fduignan/nrf52833/README.md

# nrf52833
Various projects involving the NRF52833 from Nordic Semiconductor.
The DublinMaker2022 project contains firmware for the Dublin Maker 2022 badge.  
It includes a number of games and badge to badge communications.  More details
over at https://ioprog.com
