fduignan/nrf52833/DublinMaker2022/KiCAD_PCB/dmb2022/dmb2022.kicad_pcb

## KiCad design DublinMaker2022/KiCAD_PCB/dmb2022/dmb2022.kicad_pcb (2022-07-27)

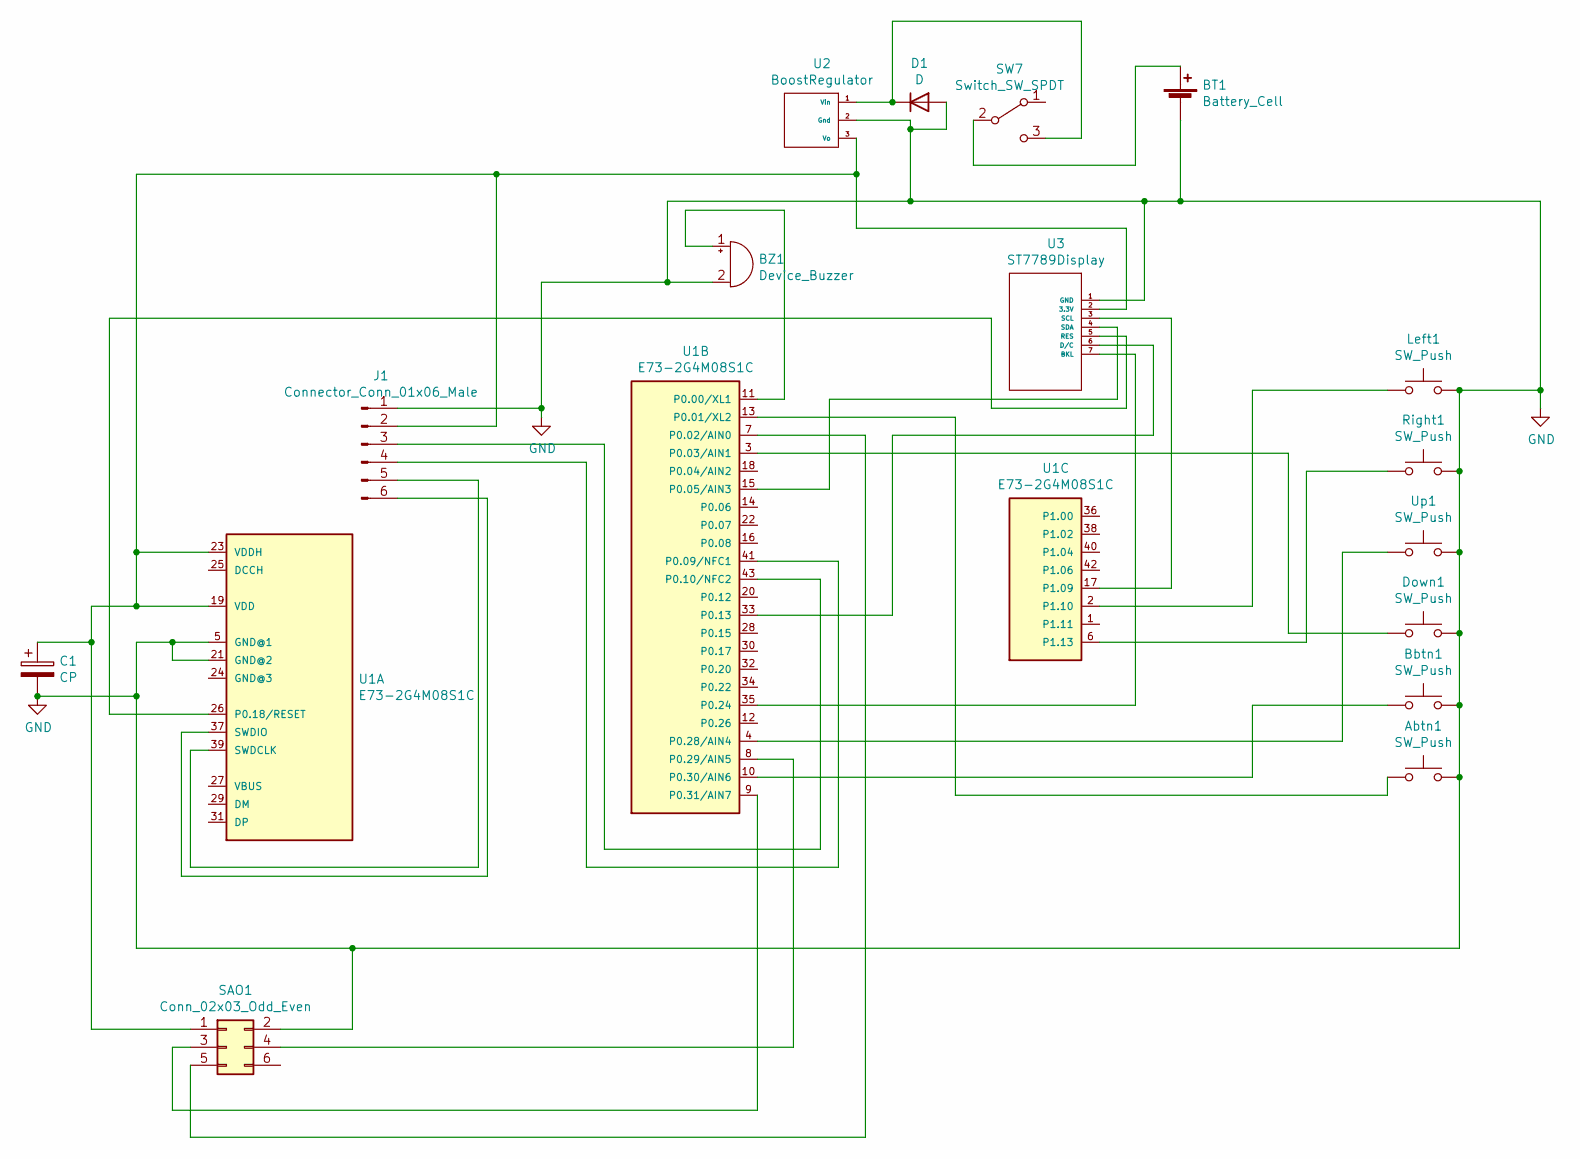
[picture p1: schematic dmb2022.sch, Dublin Maker Badge 2022]

Parts:
Abtn1: SW_Push; ST7789Display
BT1: Battery_Cell; BatteryHolder_Keystone_2460_1xAA
BZ1: Device_Buzzer; Buzzer_TDK_PS1240P02BT_D12.2mm_H6.5mm
Bbtn1: SW_Push; SW_PUSH_6mm
C1: CP; CP_Radial_D10.0mm_P5.00mm
D1: D; D_DO-34_SOD68_P7.62mm_Horizontal
Down1: SW_Push; SW_PUSH_6mm
J1: Connector_Conn_01x06_Male; PinHeader_1x06_P2.54mm_Vertical
Left1: SW_Push; SW_PUSH_6mm
Right1: SW_Push; SW_PUSH_6mm
SAO1: Conn_02x03_Odd_Even; IDC-Header_2x03_P2.54mm_Vertical
SW7: Switch_SW_SPDT; PinHeader_1x03_P2.54mm_Vertical
U1: E73-2G4M08S1C
U2: BoostRegulator; PinHeader_1x03_P2.54mm_Vertical
U3: ST7789Display; PinHeader_1x07_P2.54mm_Vertical
Up1: SW_Push; SW_PUSH_6mm

Connections:
GND: Abtn1.2, BT1.2 (-), BZ1.2 (+), Bbtn1.2, C1.2, D1.2 (A), Down1.2, J1.1, Left1.2, Right1.2, SAO1.2, U1.5 (GND@1), U1.21 (GND@2), U2.2 (Gnd), U3.1 (GND), Up1.2
unnamed: Abtn1.1, U1.13 (P0.01/XL2)
unnamed: BT1.1 (+), SW7.2 (B)
unnamed: BZ1.1 (-), U1.11 (P0.00/XL1)
unnamed: Bbtn1.1, U1.10 (P0.30/AIN6)
unnamed: C1.1, J1.2, SAO1.1, U1.19 (VDD), U1.23 (VDDH), U2.3 (Vo), U3.2 (3.3V)
unnamed: D1.1 (K), SW7.3 (C), U2.1 (Vin)
unnamed: Down1.1, U1.3 (P0.03/AIN1)
unnamed: J1.3, U1.43 (P0.10/NFC2)
unnamed: J1.4, U1.41 (P0.09/NFC1)
unnamed: J1.5, U1.39 (SWDCLK)
unnamed: J1.6, U1.37 (SWDIO)
unnamed: Left1.1, U1.2 (P1.10)
unnamed: Right1.1, U1.6 (P1.13)
unnamed: SAO1.3, U1.9 (P0.31/AIN7)
unnamed: SAO1.4, U1.8 (P0.29/AIN5)
unnamed: SAO1.5, U1.7 (P0.02/AIN0)
unnamed: U1.4 (P0.28/AIN4), Up1.1
unnamed: U1.15 (P0.05/AIN3), U3.4 (SDA)
unnamed: U1.17 (P1.09), U3.3 (SCL)
unnamed: U1.26 (P0.18/RESET), U3.5 (RES)
unnamed: U1.33 (P0.13), U3.6 (D/C)
unnamed: U1.35 (P0.24), U3.7 (BKL)

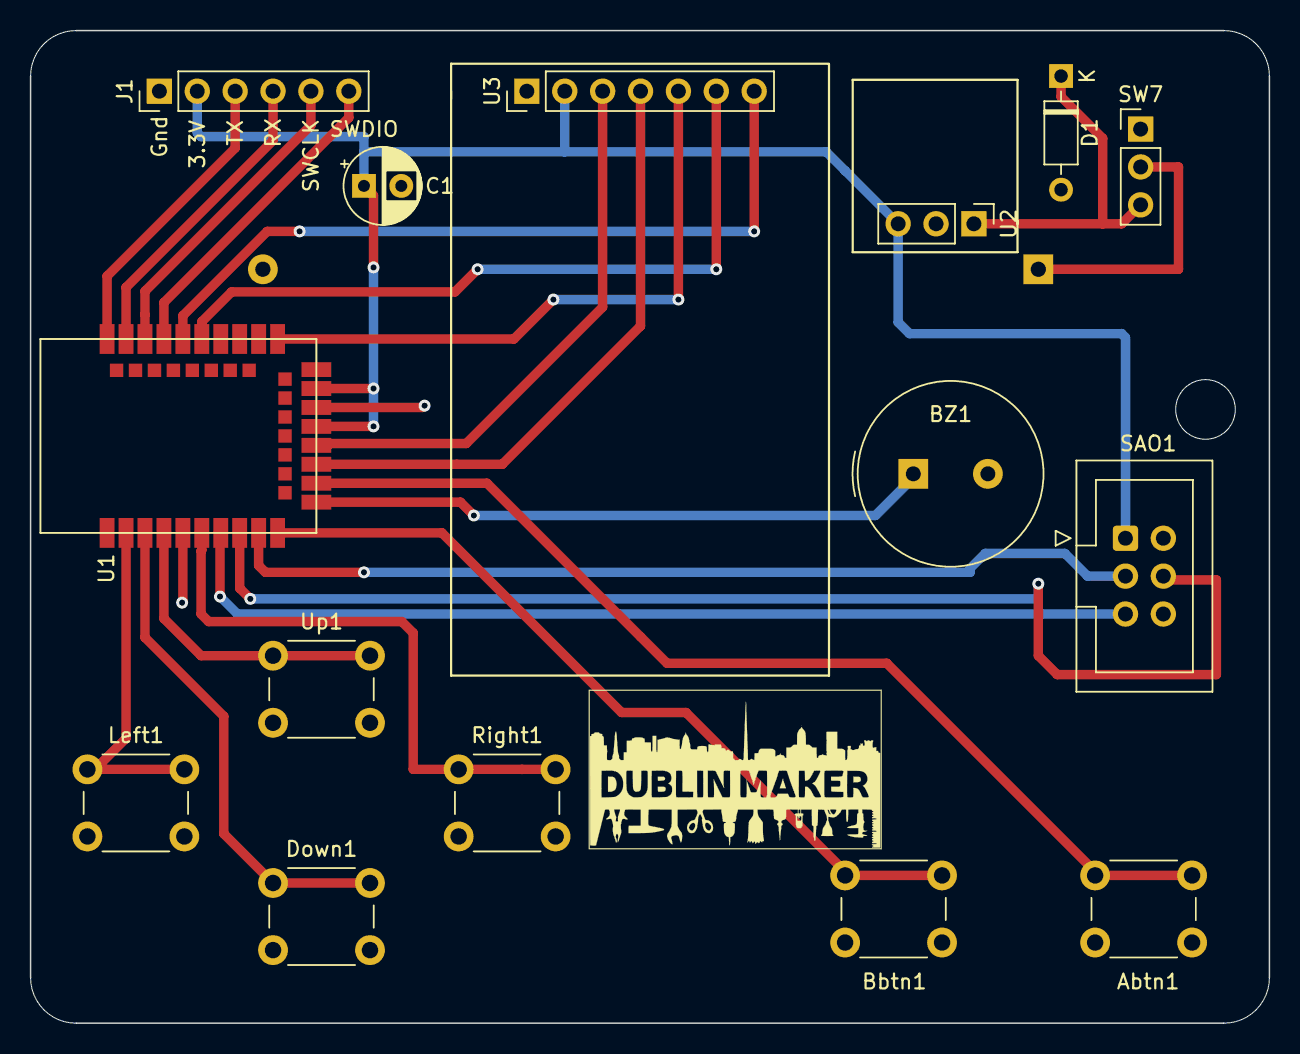
[picture p2: board dmb2022.kicad_pcb from above]

Board: 2 copper layers, 83.1 x 66.5 mm, 16 parts (1 on the bottom side), 23 nets.
