fduignan/nrf52833/DublinMaker2022/zephyr-2.6/src/controller.h

#ifndef __controller_h
#define __controller_h
#include <stdint.h>
class controller
{
public:
    controller(){};
    int begin();
    uint16_t getButtonState();    
    uint16_t readTemperature();
    void stopADC();
    // Some class-level button constants
    static const int Left = 1; 
    static const int Right = 2; 
    static const int A = 4;
    static const int Up = 8;
    static const int Down = 16;
	static const int B = 32;
};
#endif
