fduignan/nrf52833/DublinMaker2022/zephyr-3.1/src/mesh.bad.c

#include <zephyr/sys/printk.h>

#include <zephyr/settings/settings.h>

#include <zephyr/bluetooth/bluetooth.h>
#include <zephyr/bluetooth/mesh.h>
#include "dmb_message_type.h"
#define NODE_ADDR 0x0b0c


#define MOD_LF 0x0000

#define GROUP_ADDR 0xc000
#define PUBLISHER_ADDR  0x000f

#define OP_VENDOR_BUTTON BT_MESH_MODEL_OP_3(0x00, BT_COMP_ID_LF)
#define OP_DMB_MESSAGE BT_MESH_MODEL_OP_3(0xD0, BT_COMP_ID_LF)
#define OP_DMB_GAME_MESSAGE BT_MESH_MODEL_OP_3(0xD1,BT_COMP_ID_LF)
#define OP_DMB_GAME_MESSAGE_RESPONSE BT_MESH_MODEL_OP_3(0xD2,BT_COMP_ID_LF)

static const uint8_t net_key[16] = {
	0x01, 0x23, 0x45, 0x67, 0x89, 0xab, 0xcd, 0xef,
	0x01, 0x23, 0x45, 0x67, 0x89, 0xab, 0xcd, 0xef,
};
static const uint8_t dev_key[16] = {
	0x01, 0x23, 0x45, 0x67, 0x89, 0xab, 0xcd, 0xef,
	0x01, 0x23, 0x45, 0x67, 0x89, 0xab, 0xcd, 0xef,
};
static const uint8_t app_key[16] = {
	0x01, 0x23, 0x45, 0x67, 0x89, 0xab, 0xcd, 0xef,
	0x01, 0x23, 0x45, 0x67, 0x89, 0xab, 0xcd, 0xef,
};
static const uint16_t net_idx;
static const uint16_t app_idx;
static const uint32_t iv_index;
static uint8_t flags;
static uint16_t addr = NODE_ADDR;
volatile uint32_t DMBMessageReceived = 0;
volatile dmb_message DMBMailBox;
volatile uint16_t DMBMessageSender;
volatile uint32_t DMBGameMessageReceived = 0;
volatile dmb_message DMBGameMailBox;
volatile uint32_t DMBGameMessageResponseReceived = 0;
volatile dmb_message DMBGameResponseMailBox;
void mesh_clearReplay(void);

static void heartbeat(const struct bt_mesh_hb_sub *sub, uint8_t hops, uint16_t feat)
{
	printk("Heartbeat\n");
}

static struct bt_mesh_cfg_cli cfg_cli = {
};

static void attention_on(struct bt_mesh_model *model)
{
	printk("attention_on()\n");
	
}

static void attention_off(struct bt_mesh_model *model)
{
	printk("attention_off()\n");
	
}

static const struct bt_mesh_health_srv_cb health_srv_cb = {
	.attn_on = attention_on,
	.attn_off = attention_off,
};

static struct bt_mesh_health_srv health_srv = {
	.cb = &health_srv_cb,
};

BT_MESH_HEALTH_PUB_DEFINE(health_pub, 0);

static struct bt_mesh_model root_models[] = {
	BT_MESH_MODEL_CFG_SRV,
	BT_MESH_MODEL_CFG_CLI(&cfg_cli),
	BT_MESH_MODEL_HEALTH_SRV(&health_srv, &health_pub),
};
static int dmb_game_message_received(struct bt_mesh_model *model,
			       struct bt_mesh_msg_ctx *ctx,
			       struct net_buf_simple *buf)
{
    printk("Game message received\n");
    for (int i=0;i<MAX_MESSAGE_LEN;i++)
    {    
        uint8_t data = net_buf_simple_pull_u8(buf);
        DMBGameMailBox.Message[i]=data;
        printk(" %X ",data);
    }
    DMBGameMessageReceived = 1;
	return 0;
}
static int dmb_game_message_response_received(struct bt_mesh_model *model,
			       struct bt_mesh_msg_ctx *ctx,
			       struct net_buf_simple *buf)
{
    printk("Game response received\n");
    for (int i=0;i<MAX_MESSAGE_LEN;i++)
    {    
        uint8_t data = net_buf_simple_pull_u8(buf);
        DMBGameResponseMailBox.Message[i]=data;
        printk(" %X ",data);
    }
    DMBGameMessageResponseReceived = 1;
	return 0;
}
static int dmb_message_received(struct bt_mesh_model *model,
			       struct bt_mesh_msg_ctx *ctx,
			       struct net_buf_simple *buf)
{
    printk("DMB Message : ");
    for (int i=0;i<MAX_MESSAGE_LEN;i++)
    {    
        uint8_t data = net_buf_simple_pull_u8(buf);
		DMBMailBox.Message[i]=data;
        printk(" %X ",data);
    }
	printk("\n");
	printk("RSSI=%d\n",ctx->recv_rssi);
	DMBMessageReceived=1;
	DMBMessageSender=ctx->addr;
	mesh_clearReplay();

	return 0;
}
static const struct bt_mesh_model_op vnd_ops[] = {
	{ OP_DMB_MESSAGE, BT_MESH_LEN_EXACT(MAX_MESSAGE_LEN), dmb_message_received },
	{ OP_DMB_GAME_MESSAGE, BT_MESH_LEN_EXACT(MAX_MESSAGE_LEN), dmb_game_message_received },
    { OP_DMB_GAME_MESSAGE_RESPONSE, BT_MESH_LEN_EXACT(MAX_MESSAGE_LEN), dmb_game_message_response_received },
	BT_MESH_MODEL_OP_END
};

static struct bt_mesh_model vnd_models[] = {
	BT_MESH_MODEL_VND(BT_COMP_ID_LF, MOD_LF, vnd_ops, NULL, NULL),
};

static struct bt_mesh_elem elements[] = {
	BT_MESH_ELEM(0, root_models, vnd_models),
};

static const struct bt_mesh_comp comp = {
	.cid = BT_COMP_ID_LF,
	.elem = elements,
	.elem_count = ARRAY_SIZE(elements),
};

static void configure(void)
{
	printk("Configuring...\n");

	/* Add Application Key */
	bt_mesh_cfg_app_key_add(net_idx, addr, net_idx, app_idx, app_key, NULL);

	/* Bind to vendor model */
	bt_mesh_cfg_mod_app_bind_vnd(net_idx, addr, addr, app_idx,
				     MOD_LF, BT_COMP_ID_LF, NULL);

	/* Bind to Health model */
	bt_mesh_cfg_mod_app_bind(net_idx, addr, addr, app_idx,
				 BT_MESH_MODEL_ID_HEALTH_SRV, NULL);

	/* Add model subscription */
	bt_mesh_cfg_mod_sub_add_vnd(net_idx, addr, addr, GROUP_ADDR,
				    MOD_LF, BT_COMP_ID_LF, NULL);

//#if NODE_ADDR == PUBLISHER_ADDR
	{
		struct bt_mesh_cfg_hb_pub pub = {
			.dst = GROUP_ADDR,
			.count = 0xff,
			.period = 0x7,
			.ttl = 0x02,
			.feat = 0,
			.net_idx = net_idx,
		};

		bt_mesh_cfg_hb_pub_set(net_idx, addr, &pub, NULL);
		printk("Publishing heartbeat messages\n");
	}
//#endif
	printk("Configuration complete\n");
}

static const uint8_t dev_uuid[16] = { 0xdd, 0xdd };

static const struct bt_mesh_prov prov = {
	.uuid = dev_uuid,
};

BT_MESH_HB_CB_DEFINE(hb_cb) = {
	.recv = heartbeat,
};

static void bt_ready(int err)
{
	if (err) {
		printk("Bluetooth init failed (err %d)\n", err);
		return;
	}
	
	printk("Bluetooth initialized\n");

	err = bt_mesh_init(&prov, &comp);
	if (err) {
		printk("Initializing mesh failed (err %d)\n", err);
		return;
	}
	printk("Mesh initialized\n");

/*	if (IS_ENABLED(CONFIG_BT_SETTINGS)) {
		printk("Loading stored settings\n");
		settings_load();
	}
*/
	err = bt_mesh_provision(net_key, net_idx, flags, iv_index, addr,
				dev_key);

	if (err == -EALREADY) {
		printk("Using stored settings\n");
	} else if (err) {
		printk("Provisioning failed (err %d)\n", err);
		return;
	} else {
		printk("Provisioning completed\n");
		configure();
	}
	
	/* Heartbeat subcscription is a temporary state (due to there
	 * not being an "indefinite" value for the period, so it never
	 * gets stored persistently. Therefore, we always have to configure
	 * it explicitly.
	 */
	struct bt_mesh_cfg_hb_sub sub = {
		.src = PUBLISHER_ADDR,
		.dst = GROUP_ADDR,
		.period = 0x7,
	};

	bt_mesh_cfg_hb_sub_set(net_idx, addr, &sub, NULL);
	printk("Subscribing to heartbeat messages\n");
//	bt_mesh_suspend(); // Suspend the network when not in use - saves about 10mA at 3.3V.  Stops the heartbeat service
	
}

static uint16_t target = GROUP_ADDR;

void mesh_begin(uint16_t address)
{
	addr = address;
	target = 0x000f;
	vnd_models[0].keys[0]=0;
	bt_enable(bt_ready);
}
void mesh_clearReplay()
{
	int err;
	//bt_mesh_rpl_clear();
	

}
void mesh_suspend()
{
	bt_mesh_suspend();
}
void mesh_resume()
{
	bt_mesh_resume();
}
void mesh_send_start(uint16_t duration, int err, void *cb_data)
{
        printk("send_start duration = %d, err = %d\n",duration,err);
}
void mesh_send_end(int err, void *cb_data)
{
        printk("send_end err=%d\n",err);
};
const struct bt_mesh_send_cb dmb_send_sb_s = { 
        .start = mesh_send_start,
        .end = mesh_send_end,
};

void sendDMBMessage(uint16_t the_target, dmb_message * dmbmsg)
{
        int err;
        NET_BUF_SIMPLE_DEFINE(msg, 3 + 4 + MAX_MESSAGE_LEN);
        struct bt_mesh_msg_ctx ctx = {
                .app_idx = vnd_models[0].keys[0],
                .addr = the_target,
                .send_ttl = BT_MESH_TTL_DEFAULT,
        };

        bt_mesh_model_msg_init(&msg, OP_DMB_MESSAGE);   
        for (int i=0;i<MAX_MESSAGE_LEN;i++)
        {
            net_buf_simple_add_u8(&msg,dmbmsg->Message[i]);
        }
        printk("Model key = %d\n",vnd_models[0].keys[0]);
        err = bt_mesh_model_send(&vnd_models[0], &ctx, &msg,&dmb_send_sb_s, NULL);
        if (err) {
                printk("Unable to send DMB message %d\n",err);
        }

        printk("DMB message sent with OpCode 0x%08x\n", OP_DMB_MESSAGE);
		mesh_clearReplay();

}

void sendDMBGameMessage(uint16_t the_target, dmb_message * dmbmsg)
{
        int err;
        NET_BUF_SIMPLE_DEFINE(msg, 3 + 4 + MAX_MESSAGE_LEN);
        struct bt_mesh_msg_ctx ctx = {
                .app_idx = app_idx,
                .addr = the_target,
                .send_ttl = BT_MESH_TTL_DEFAULT,
        };

        bt_mesh_model_msg_init(&msg, OP_DMB_GAME_MESSAGE);   
        for (int i=0;i<MAX_MESSAGE_LEN;i++)
        {
            net_buf_simple_add_u8(&msg,dmbmsg->Message[i]);
        }
        err = bt_mesh_model_send(&vnd_models[0], &ctx, &msg,&dmb_send_sb_s, NULL);
        if (err) {
                printk("Unable to send DMB game message %d\n",err); 
        }

        printk("DMB game message sent\n");
}

void sendDMBGameResponseMessage(uint16_t the_target, dmb_message * dmbmsg)
{
        int err;
        NET_BUF_SIMPLE_DEFINE(msg, 3 + 4 + MAX_MESSAGE_LEN);
        struct bt_mesh_msg_ctx ctx = {
                .app_idx = app_idx	,
                .addr = the_target,
                .send_ttl = BT_MESH_TTL_DEFAULT,
        };

        bt_mesh_model_msg_init(&msg, OP_DMB_GAME_MESSAGE_RESPONSE);   
        printk("\nResponse data ");
        for (int i=0;i<MAX_MESSAGE_LEN;i++)
        {
            printk(" %X ",dmbmsg->Message[i]);
            net_buf_simple_add_u8(&msg,dmbmsg->Message[i]);
        }
        err = bt_mesh_model_send(&vnd_models[0], &ctx, &msg,&dmb_send_sb_s, NULL);
        if (err) {
                printk("Unable to send DMB game response message %d\n",err);
        }

        printk("DMB game response message sent\n");
}
