fduignan/nrf52833/DublinMaker2022/zephyr-2.6/src/char1.h

#define char1_width 30
#define char1_height 30
static const uint16_t char1[]={
65535,
65535,
65535,
65535,
65535,
65535,
65535,
65535,
65535,
65535,
65535,
65535,
65535,
65535,
65535,
65535,
65535,
65535,
65535,
65535,
65535,
65535,
65535,
65535,
65535,
65535,
65535,
65535,
65535,
65535,
65535,
65535,
65535,
65535,
65535,
65535,
65535,
65535,
65535,
65535,
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
};
