fduignan/nrf52833/DublinMaker2022/zephyr-2.6/src/grass.h

#define tile_width 30
#define tile_height 30
static const uint16_t tile[]={
65503,
65503,
65503,
4,
65503,
65503,
4,
65503,
65503,
65503,
65503,
65503,
65503,
65503,
65503,
65503,
65503,
4,
4,
4,
4,
65503,
65503,
65503,
65503,
4,
65503,
4,
65503,
65503,
65503,
65503,
65503,
65503,
65503,
4,
65503,
4,
65503,
4,
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
};
