fduignan/nrf52833/DublinMaker2022/zephyr-2.6/src/logo_bricks.h

const uint8_t brickattribs[]={
10,52,5,21,15, 
15,52,8,4,15, 
15,69,8,4,15, 
22,57,5,13,15, 
31,53,5,17,15, 
43,52,5,17,15, 
33,69,12,4,15, 
51,52,6,21,15, 
57,52,6,4,15, 
57,60,6,4,15, 
57,69,6,4,15, 
63,54,5,7,15, 
63,63,5,7,15, 
71,52,5,21,15, 
76,69,10,4,15, 
89,52,5,21,15, 
98,52,5,21,15, 
103,52,8,4,15, 
111,52,5,21,15, 
125,53,5,21,12, 
141,53,5,21,12, 
134,53,3,21,12, 
130,53,4,2,12, 
137,53,4,2,12, 
149,53,5,21,12, 
164,53,5,21,12, 
154,62,11,4,12, 
154,53,11,2,12, 
173,52,5,21,12, 
178,61,5,3,12, 
183,55,4,6,12, 
183,65,4,6,12, 
183,71,6,3,12, 
183,52,7,3,12, 
194,52,5,21,12, 
199,52,10,4,12, 
199,69,10,4,12, 
199,60,10,4,12, 
212,52,5,21,12, 
217,52,6,4,12, 
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
};
#define LOGO_BRICK_COUNT  157
