fduignan/nrf52833/(commit log)

2022-07-27 Added KiCAD files
    [dmb2022-B_Cu.gbl, dmb2022-B_Mask.gbs, dmb2022-B_SilkS.gbo, dmb2022-Edge_Cuts.gm1, dmb2022-F_Cu.gtl, dmb2022-F_Mask.gts, dmb2022-F_SilkS.gto, dmb2022-NPTH.drl]
2022-09-26 Lots of changes to accommodate Zephyr 3.1. Mesh comms not working yet
    [battleship.cpp, battleship.h, brici.cpp, brick.cpp, brick.h, char1.h]
